KimotoHoitsu/Voiture-guidee-par-main/box.stl

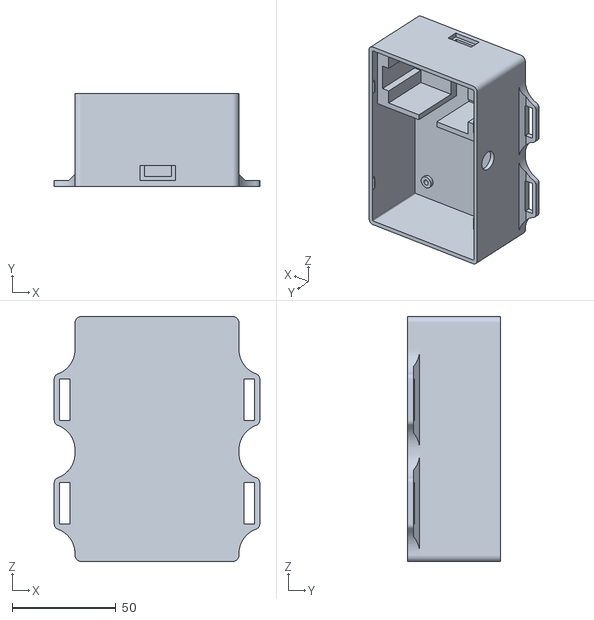
[picture p1: CAD file, 2025-05-15]
box.stl
99.0 x 45.0 x 118.0
