KimotoHoitsu/Voiture-guidee-par-main/Designe 3D (Manette)/Manette/Manette.step

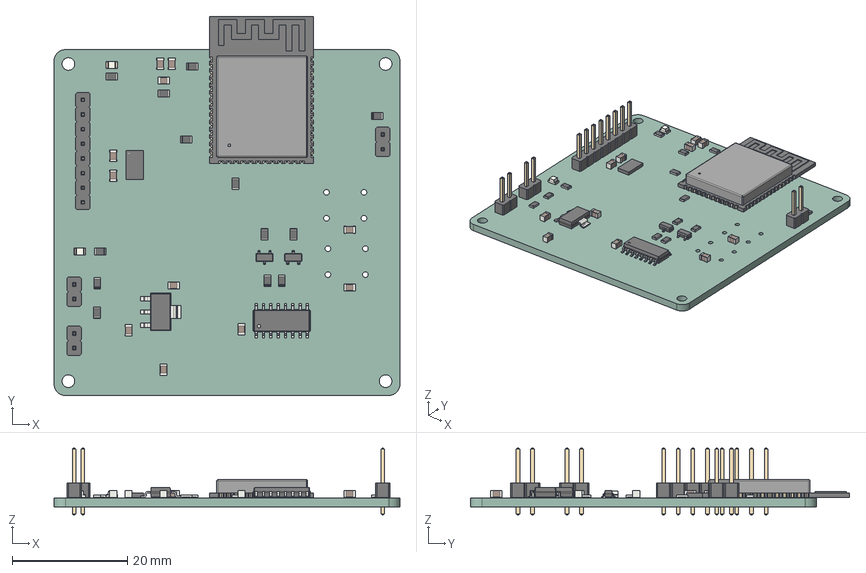
[picture p2: CAD file, 2025-05-15]
Designe 3D (Manette)/Manette/Manette.step
60.0 x 65.8 x 11.5 mm
R_0805_2012Metric x 13
C_0805_2012Metric x 11
LED_0805_2012Metric x 2
ESP32-S3-WROOM-1
PinHeader_1x02_P254mm_Vertical x 3
SOIC_16_39x99mm_P127mm
PinHeader_1x08_P254mm_Vertical
SOT_23 x 2
LGA_14_3x5mm_P08mm_LayoutBorder1x6y
SOT_223
Manette_PCB
