KimotoHoitsu/Voiture-guidee-par-main/Designe 3D (Manette)/Voiture/Voiture.step

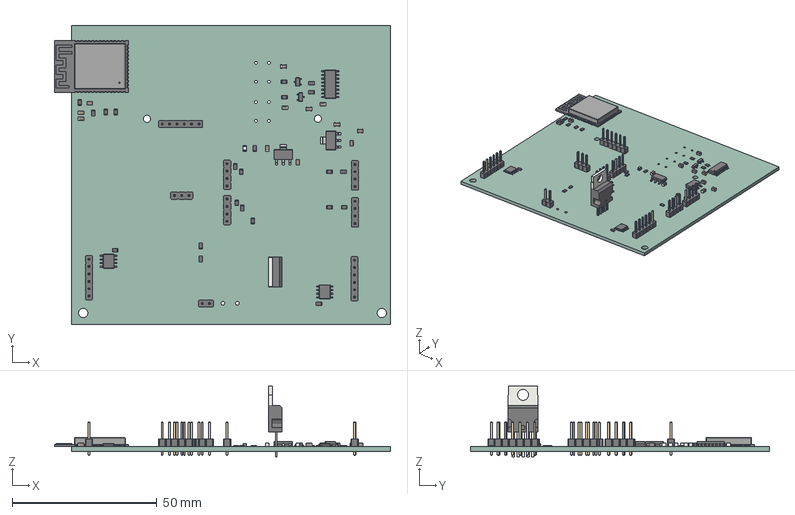
[picture p3: CAD file, 2025-05-15]
Designe 3D (Manette)/Voiture/Voiture.step
115.9 x 103.2 x 24.4 mm
C_0805_2012Metric x 12
PinHeader_1x04_P254mm_Vertical x 4
PinHeader_1x06_P254mm_Vertical x 3
ESP32-S3-WROOM-1
R_0805_2012Metric x 22
LED_0805_2012Metric
TO_220_5_Pentawatt_Multiwatt_5_Vertical
SOT_23 x 2
PinHeader_1x02_P254mm_Vertical
Texas_HTSOP_8_1EP_39x49mm_P127mm_EP285x49mm_Mask24x31mm_ThermalVias x 2
SOT_223 x 2
SOIC_16_39x99mm_P127mm
PinHeader_1x03_P254mm_Vertical
_autosave-Voiture_PCB
