KimotoHoitsu/Voiture-guidee-par-main/lid.stl

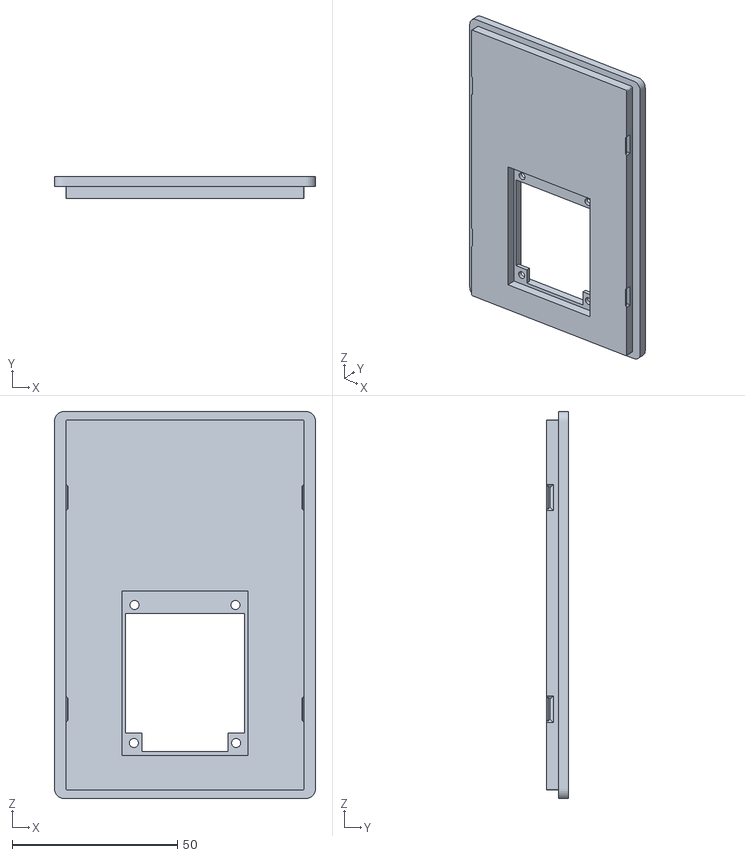
[picture p4: CAD file, 2025-05-15]
lid.stl
79.0 x 6.50 x 117.0
