KimotoHoitsu/Voiture-guidee-par-main/PCB/Manette/Manette.pdf

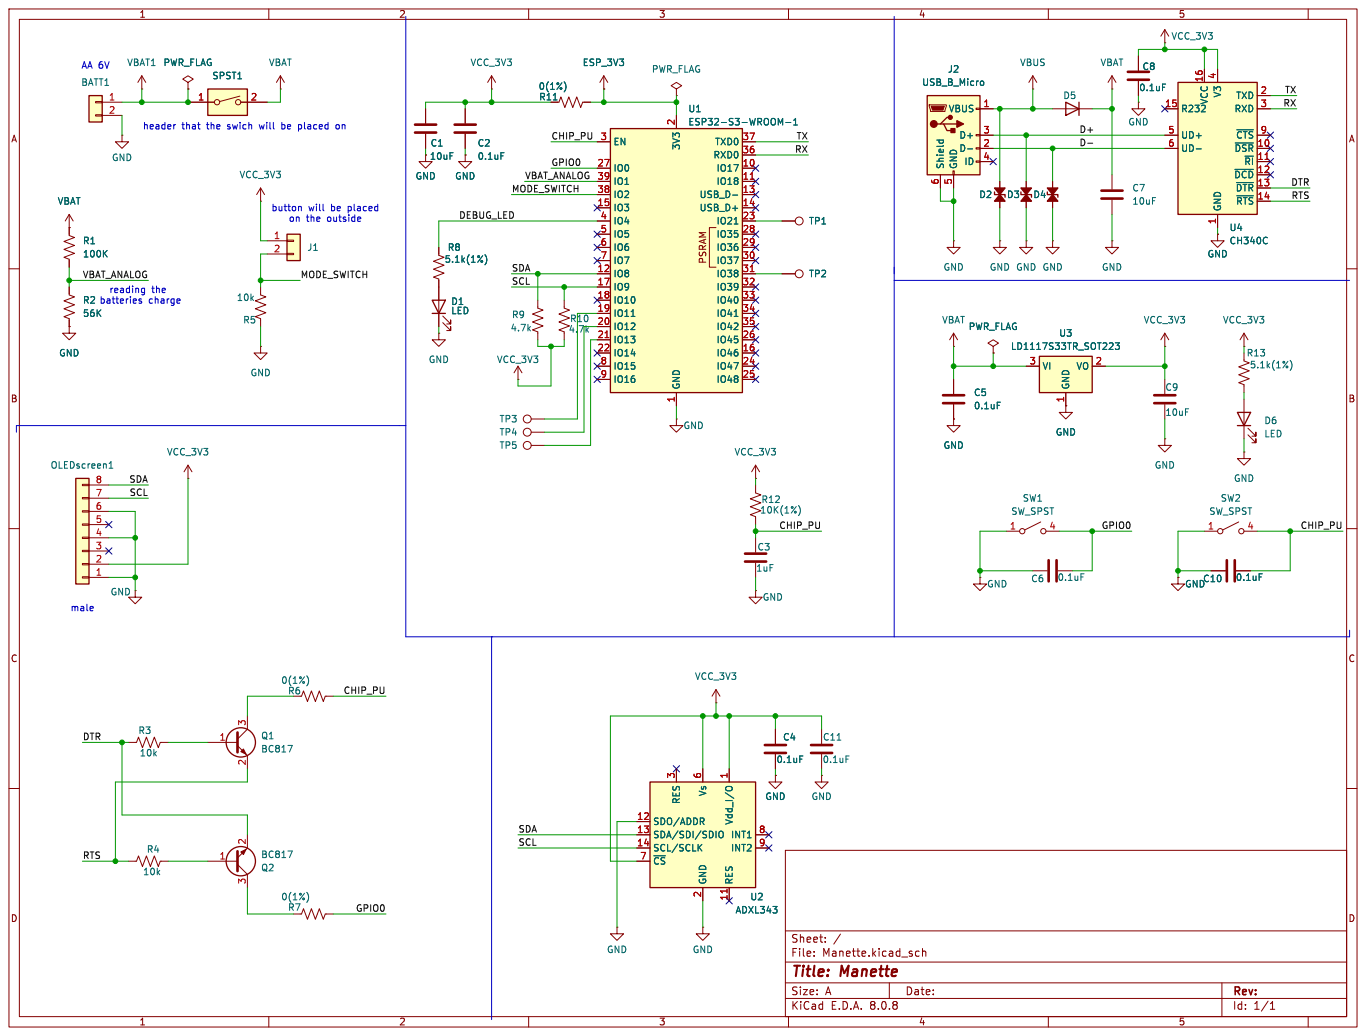
[picture p5: page 1]

1 ~{DSR} 10 ~{RI} 11 ~{DCD} 12 ~{DTR} 13 ~{RTS} 14 R232 15 VCC 16 TXD 2 RXD 3 V3

4 UD+ 5 UD- 6 ~{CTS}9 GND

on the outside male

button will be placed

1 RES 11 SDO/ADDR 12 SDA/SDI/SDIO 13 SCL/SCLK 14 GND
