KimotoHoitsu/Voiture-guidee-par-main/PCB/Voiture/Voiture.pdf

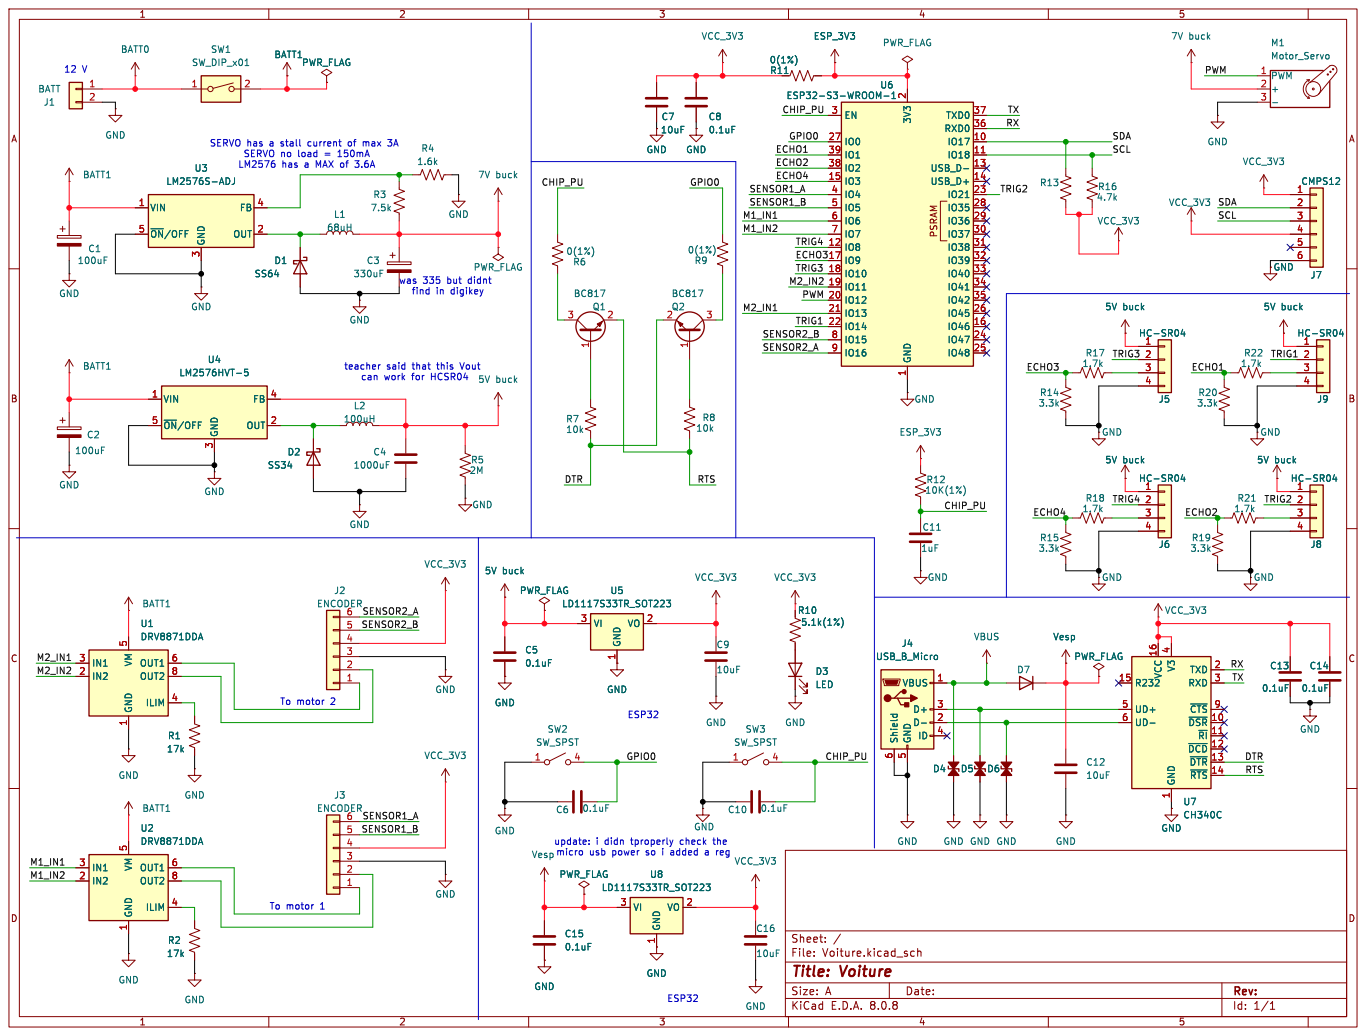
[picture p6: page 1]

3 FB 4 ~{ON}/OFF 5 D1 SS64 U6 ESP32-S3-WROOM-1 GND

SERVO has a stall current of max 3A

teacher said that this Vout can work for HCSR04

4 UD+ 5 UD- 6 ~{CTS}9 Vesp GND
0.1uF PWR_FLAG

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

ESP32 ESP32 To motor 1 To motor 2
