KimotoHoitsu/Voiture-guidee-par-main/PCB/Manette/Manette.kicad_pcb

## KiCad design PCB/Manette/Manette.kicad_pcb (2025-05-15)

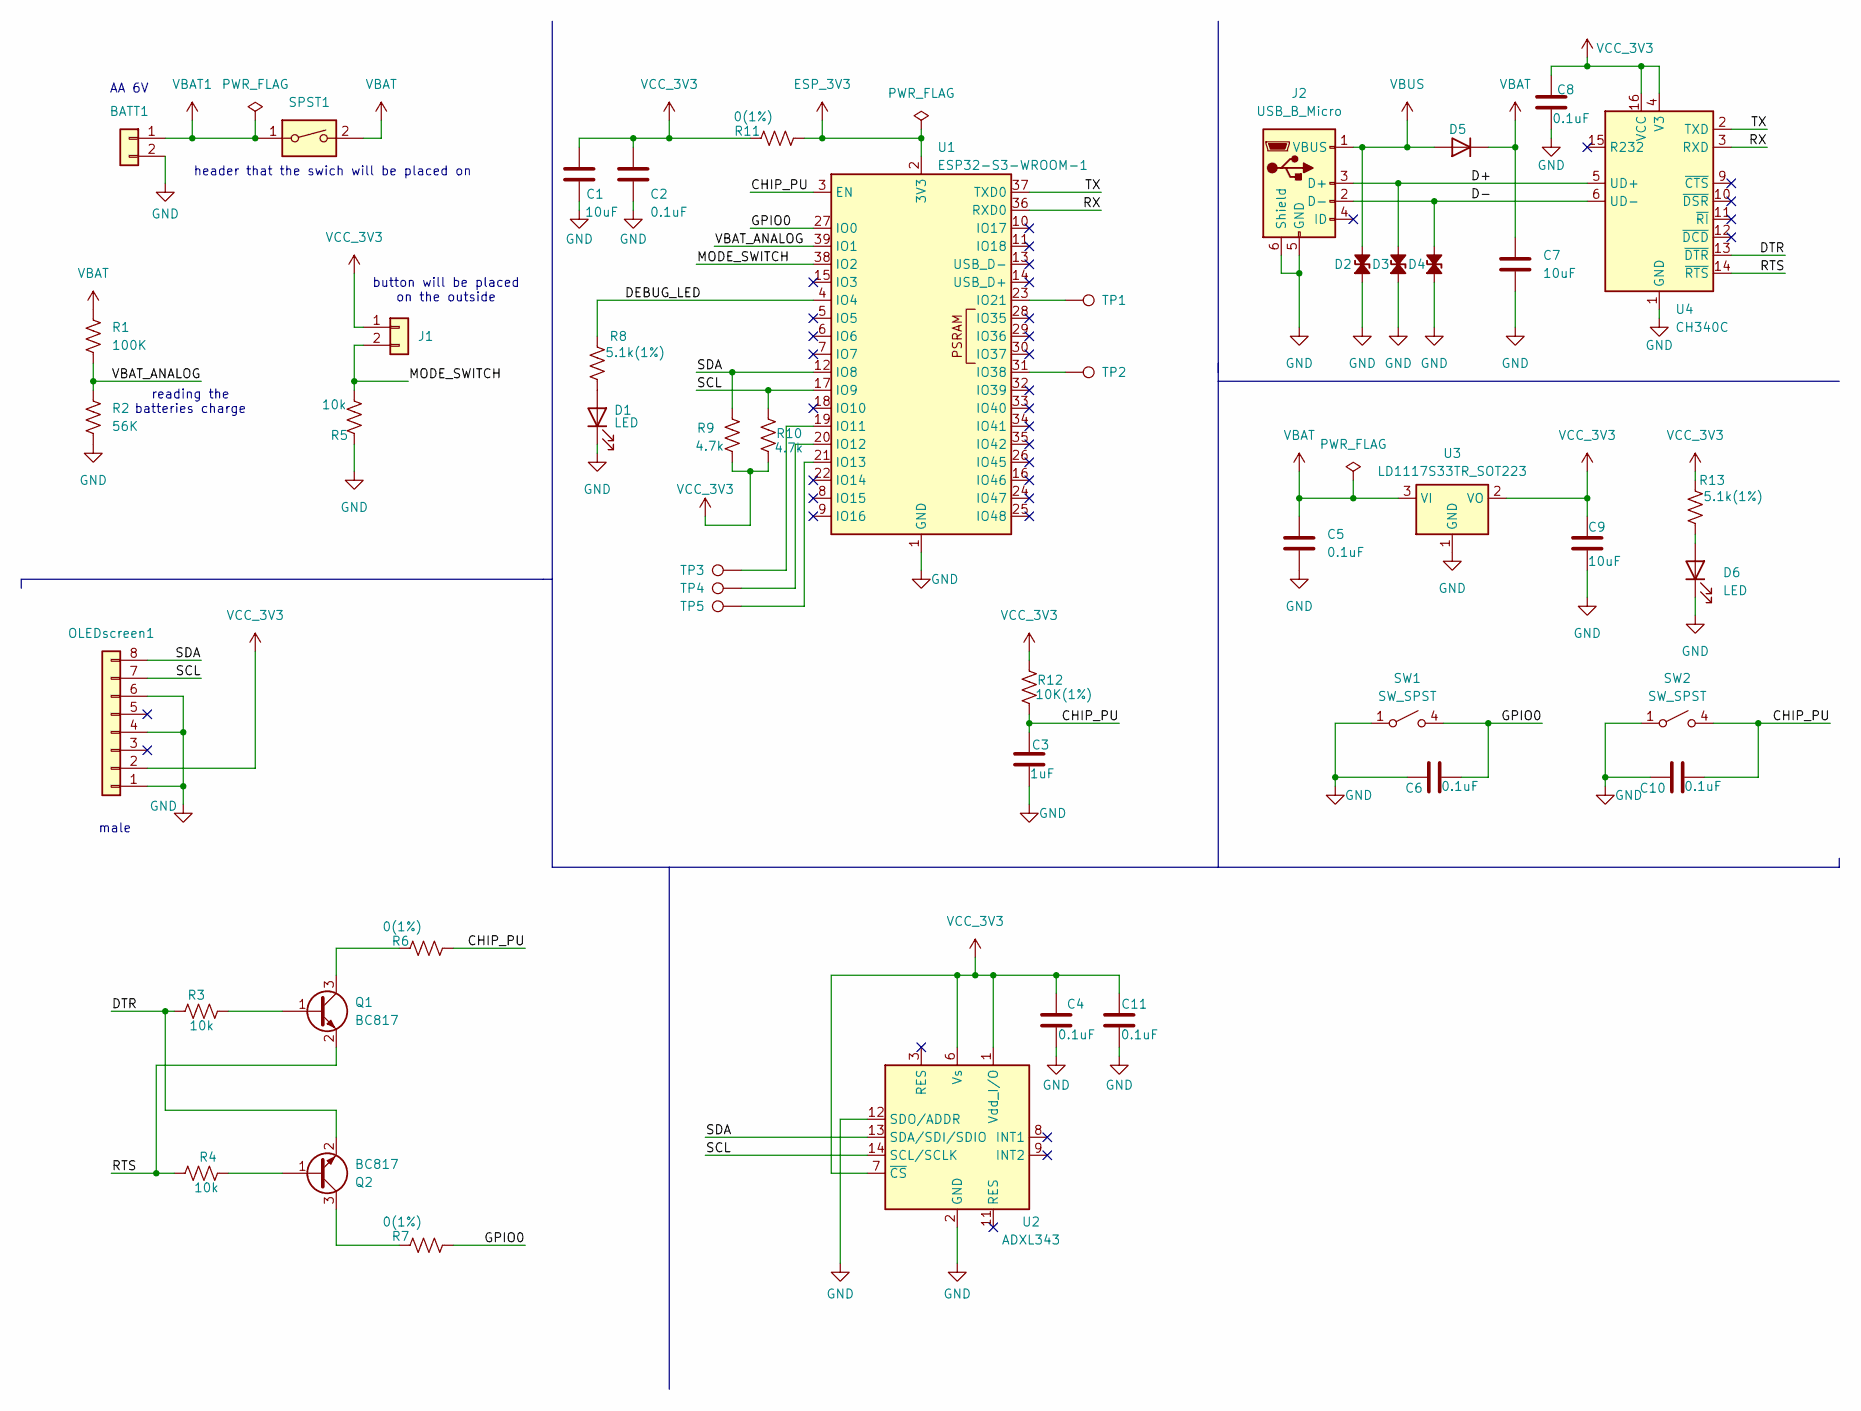
[picture p7: schematic Manette.kicad_sch]

Parts:
BATT1: 9V; PinHeader_1x02_P2.54mm_Vertical
C1, C7, C9: 10uF; C_0805_2012Metric
C2, C4, C5, C6, C8, C10, C11: 0.1uF; C_0805_2012Metric
C3: 1uF; C_0805_2012Metric
D1, D6: LED; LED_0805_2012Metric
D2, D3, D4: DiodeZz
D5: 1N5819HW-7-F_DIO-L
J1: SPST; PinHeader_1x02_P2.54mm_Vertical
J2: USB_B_Micro; Micro_Usb
OLEDscreen1: Conn_01x08; PinHeader_1x08_P2.54mm_Vertical
Q1, Q2: BC817; SOT-23
R1: 100K; R_0805_2012Metric
R2: 56K; R_0805_2012Metric
R3, R4, R5: 10k; R_0805_2012Metric
R6, R7, R11: 0(1%); R_0805_2012Metric
R8, R13: 5.1k(1%); R_0805_2012Metric
R9, R10: 4.7k; R_0805_2012Metric
R12: 10K(1%); R_0805_2012Metric
SPST1: SW_DIP_x01; PinHeader_1x02_P2.54mm_Vertical
SW1: SW_SPST; switch
SW2: SW_SPST; switch; MPN 1825910-6
TP1, TP2: TestPoint; testpoint
TP3, TP4, TP5: TestPoint; TestPoint_Pad_D1.0mm
U1: ESP32-S3-WROOM-1
U2: ADXL343; LGA-14_3x5mm_P0.8mm_LayoutBorder1x6y
U3: LD1117S33TR_SOT223; SOT-223-3_TabPin2
U4: CH340C; SOIC-16_3.9x9.9mm_P1.27mm

Connections:
/CHIP_PU: C3.1, C10.2, R6.2, R12.2, SW2.4 (B), U1.3 (EN)
/D+: D3.2 (A2), J2.3 (D+), U4.5 (UD+)
/D-: D4.2 (A2), J2.2 (D-), U4.6 (UD-)
/DEBUG_LED: R8.2, U1.4 (IO4)
/DTR: Q2.2 (E), R3.2, U4.13 (~DTR)
/GPIO0: C6.2, R7.2, SW1.4 (B), U1.27 (IO0)
/MODE_SWITCH: J1.2, R5.2, U1.38 (IO2)
/RTS: Q1.2 (E), R4.1, U4.14 (~RTS)
/RX: U1.36 (RXD0), U4.3 (RXD)
/SCL: OLEDscreen1.7 (CLK), R10.1, U1.17 (IO9), U2.14 (SCL/SCLK)
/SDA: OLEDscreen1.8 (DATA), R9.1, U1.12 (IO8), U2.13 (SDA/SDI/SDIO)
/TX: U1.37 (TXD0), U4.2 (TXD)
/VBAT_ANALOG: R1.1, R2.2, U1.39 (IO1)
ESP_3V3: R11.2, U1.2 (3V3)
GND: BATT1.2, C1.2, C2.2, C3.2, C4.1, C5.2, C6.1, C7.2, C8.2, C9.2, C10.1, C11.1, D1.1 (K), D2.1 (A1), D3.1 (A1), D4.1 (A1), D6.1 (K), J2.5 (GND), J2.6 (Shield), OLEDscreen1.1 (GND), OLEDscreen1.4 (CS), OLEDscreen1.6 (DC), R2.1, R5.1, SW1.1 (A), SW2.1 (A), U1.1 (GND), U1.40 (GND), U1.41 (GND), U2.2 (GND), U2.4 (GND), U2.5 (GND), U2.12 (SDO/ADDR), U3.1 (GND), U4.1 (GND)
unnamed: D1.2 (A), R8.1
unnamed: D6.2 (A), R13.1
unnamed: Q1.1 (B), R3.1
unnamed: Q1.3 (C), R6.1
unnamed: Q2.1 (B), R4.2
unnamed: Q2.3 (C), R7.1
unnamed: TP3.1, U1.19 (IO11)
unnamed: TP4.1, U1.20 (IO12)
unnamed: TP5.1, U1.21 (IO13)
unnamed: TP1.1, U1.23 (IO21)
unnamed: TP2.1, U1.31 (IO38)
VBAT: C5.1, C7.1, D5.1 (K), R1.2, SPST1.2, U3.3 (VI)
VBAT1: BATT1.1, SPST1.1
VBUS: D2.2 (A2), D5.2 (A), J2.1 (VBUS)
VCC_3V3: C1.1, C2.1, C4.2, C8.1, C9.1, C11.2, J1.1, OLEDscreen1.2 (Vin), R9.2, R10.2, R11.1, R12.1, R13.2, U2.1 (Vdd_I/O), U2.6 (Vs), U2.7 (~CS), U3.2 (VO), U4.4 (V3), U4.16 (VCC)

Notes on the sheet:
reading the batteries charge
male
AA 6V
button will be placed on the outside
header that the swich will be placed on

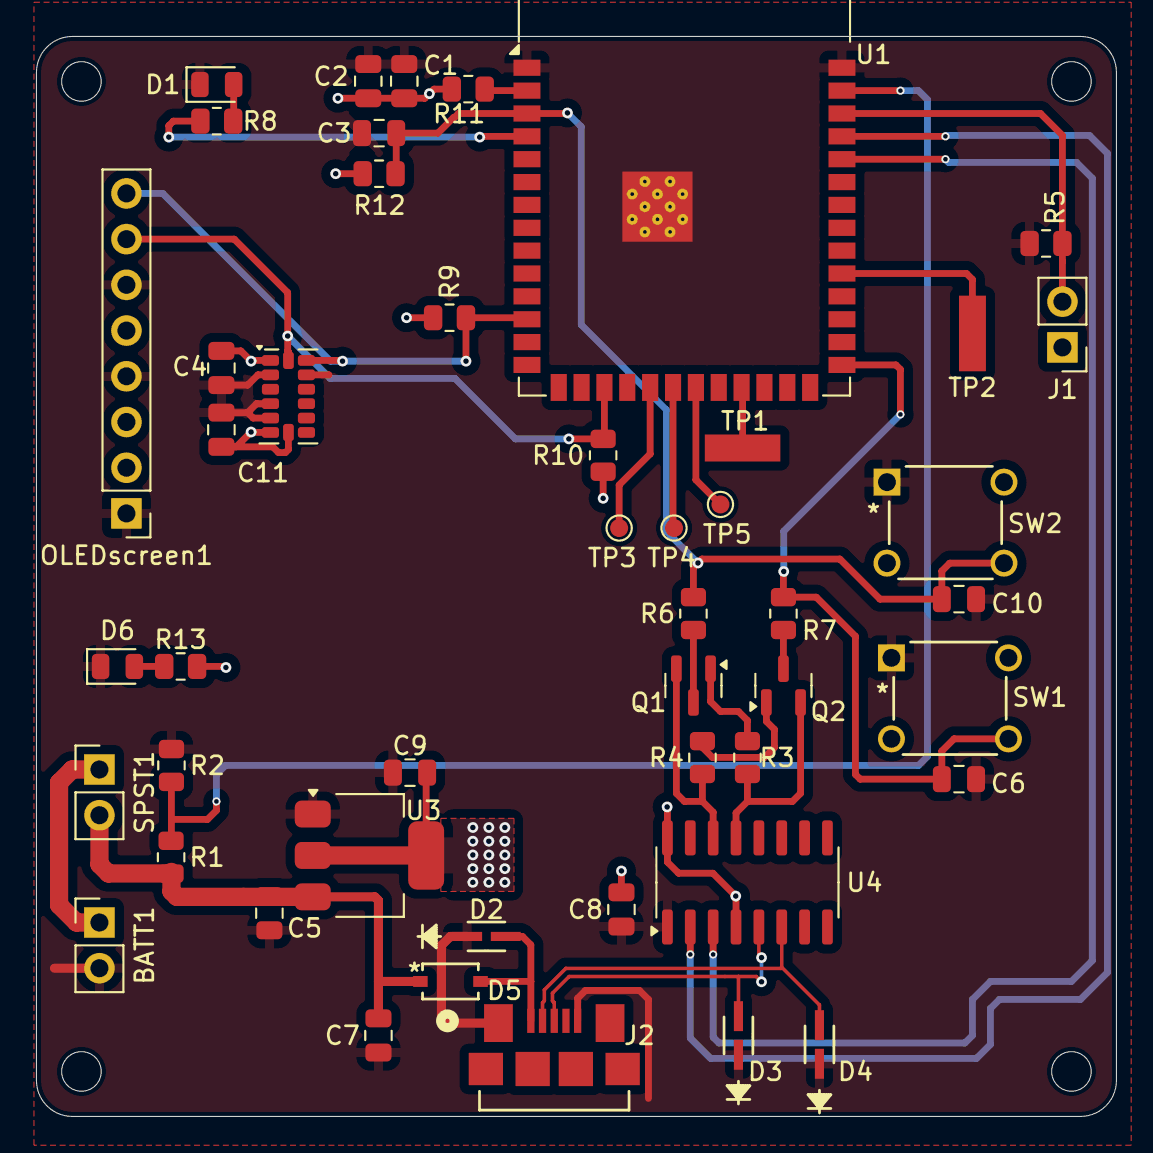
[picture p8: board Manette.kicad_pcb from above]

Board: 2 copper layers, 60.0 x 60.0 mm, 52 parts (0 on the bottom side), 30 nets.

Other parts of the board:
H1, H2, H3, H4: MountingHole_2.2mm_M2
