KimotoHoitsu/Voiture-guidee-par-main/PCB/Voiture/Voiture.kicad_pcb

## KiCad design PCB/Voiture/Voiture.kicad_pcb (2025-05-15)

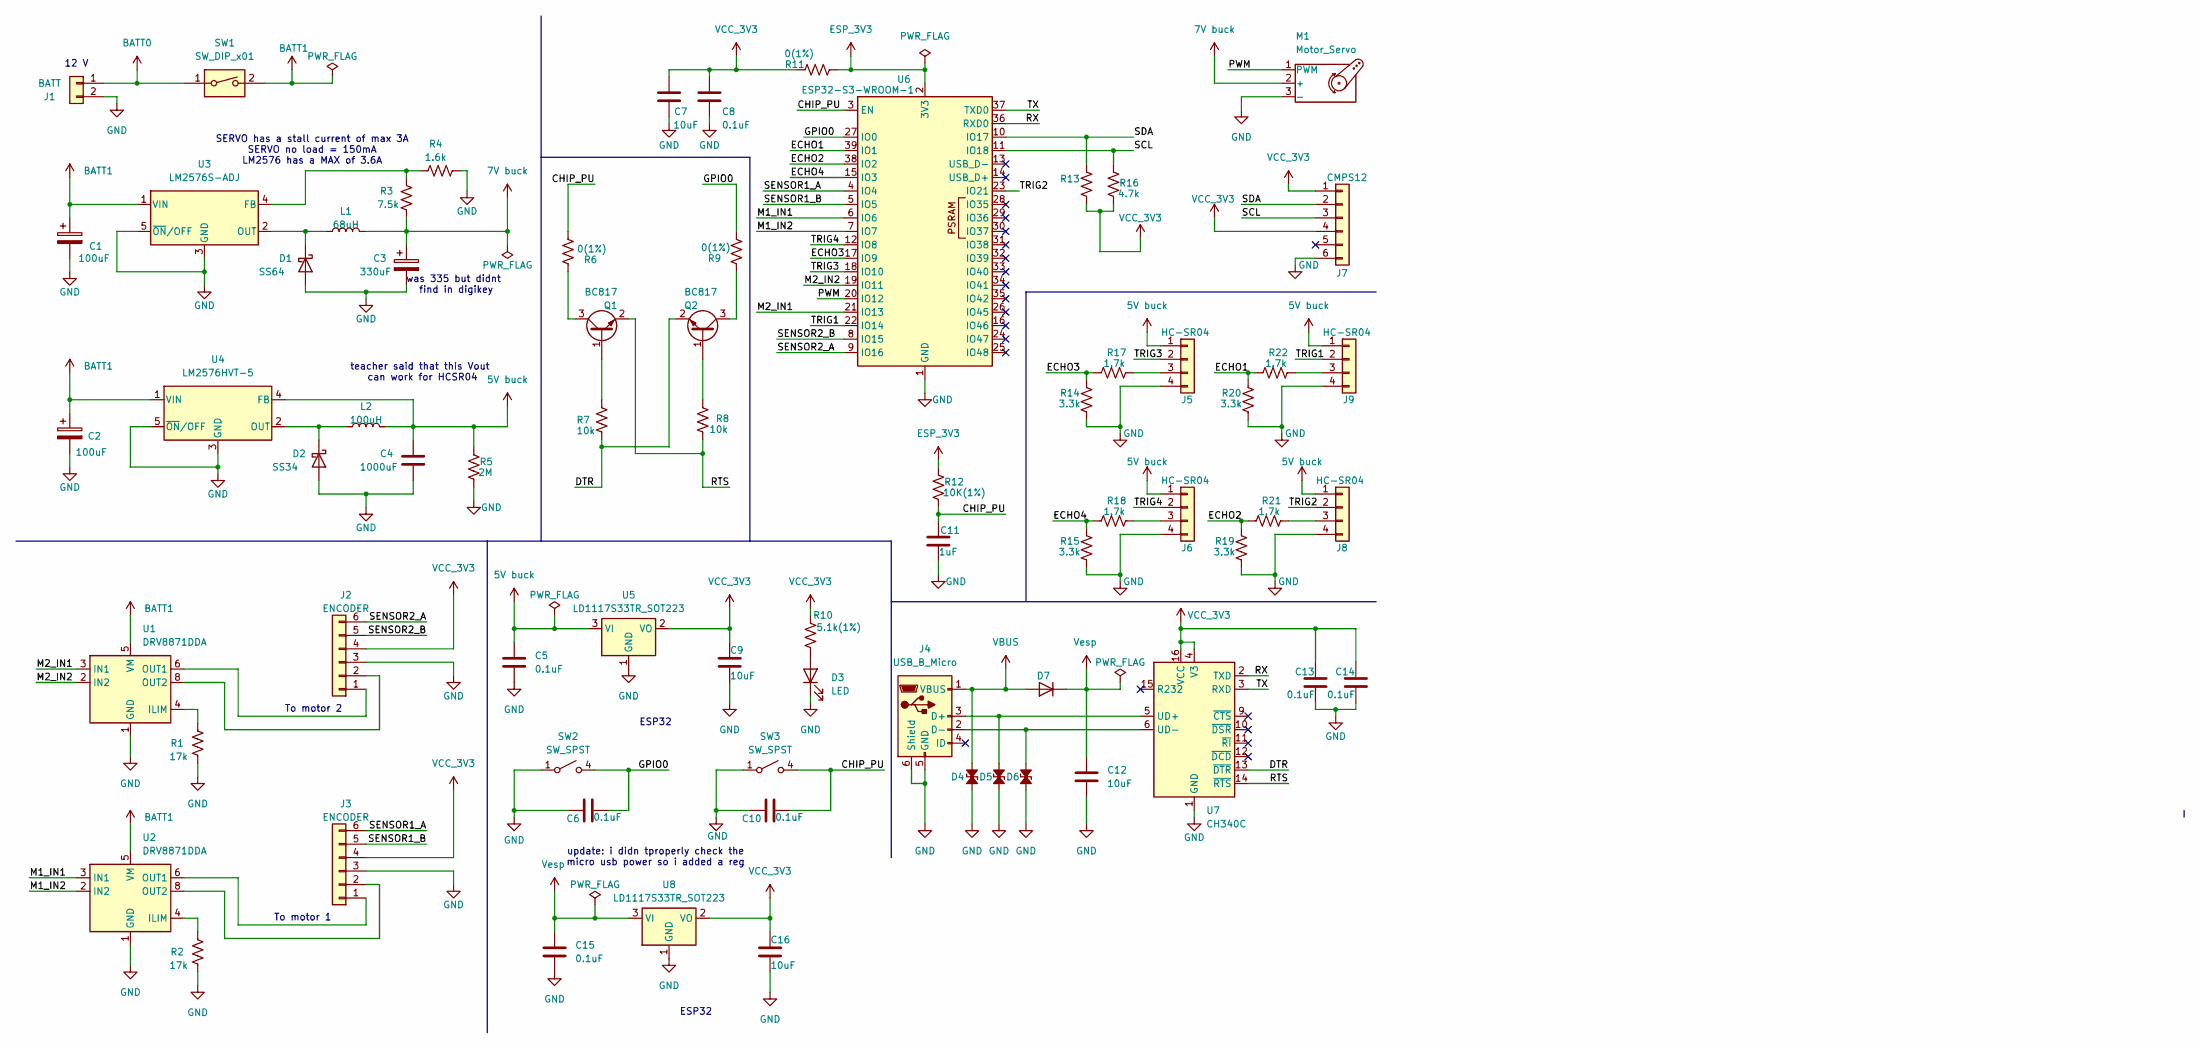
[picture p9: schematic Voiture.kicad_sch]

Parts:
C1, C2: 100uF; CAP_E61_CHC-M
C3: 330uF; CAP_APXG160ARA331MH70G
C4: 1000uF; CAP_A768MS_KEM-M
C5, C6, C8, C10, C13, C14, C15: 0.1uF; C_0805_2012Metric
C7, C9, C12, C16: 10uF; C_0805_2012Metric
C11: 1uF; C_0805_2012Metric
D1: SS64; ss34
D2: SS34; ss34
D3: LED; LED_0805_2012Metric
D4, D5, D6: DiodeZz
D7: 1N5819HW-7-F_DIO-L
J1: BATT; CONN_1935310_PXC
J2, J3: ENCODER; PinHeader_1x06_P2.54mm_Vertical
J4: USB_B_Micro; Micro_Usb
J5, J6, J8, J9: HC-SR04; PinHeader_1x04_P2.54mm_Vertical
J7: CMPS12; PinHeader_1x06_P2.54mm_Vertical
L1: 68uH; IND_DR127_EAT
L2: 100uH; DR127
M1: Motor_Servo; PinHeader_1x03_P2.54mm_Vertical
Q1, Q2: BC817; SOT-23
R1, R2: 17k; R_0805_2012Metric
R3: 7.5k; R_0805_2012Metric
R4: 1.6k; R_0805_2012Metric
R5: 2M; R_0805_2012Metric
R6, R9, R11: 0(1%); R_0805_2012Metric
R7, R8: 10k; R_0805_2012Metric
R10: 5.1k(1%); R_0805_2012Metric
R12: 10K(1%); R_0805_2012Metric
R13, R16: 4.7k; R_0805_2012Metric
R14, R15, R19, R20: 3.3k; R_0805_2012Metric
R17, R18, R21, R22: 1.7k; R_0805_2012Metric
SW1: SW_DIP_x01; PinHeader_1x02_P2.54mm_Vertical
SW2, SW3: SW_SPST; switch
U1, U2: DRV8871DDA; Texas_HTSOP-8-1EP_3.9x4.9mm_P1.27mm_EP2.95x4.9mm_Mask2.4x3.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
U3: LM2576S-ADJ; VREG_TPS79625KTTR
U4: LM2576HVT-5; TO-220-5_Vertical
U5, U8: LD1117S33TR_SOT223; SOT-223-3_TabPin2
U6: ESP32-S3-WROOM-1
U7: CH340C; SOIC-16_3.9x9.9mm_P1.27mm

Connections:
5V buck: C4.1, C5.1, J5.1 (VCC), J6.1 (VCC), J8.1 (VCC), J9.1 (VCC), L2.2, R5.1, U4.4 (FB), U5.3 (VI)
7V buck: C3.1, C3.P, L1.2, M1.2 (+), R3.2
/CHIP_PU: C10.2, C11.1, R6.2, R12.2, SW3.4 (B), U6.3 (EN)
/DTR: Q2.2 (E), R7.2, U7.13 (~DTR)
/ECHO1: R20.1, R22.1, U6.39 (IO1)
/ECHO2: R19.1, R21.1, U6.38 (IO2)
/ECHO3: R14.1, R17.1, U6.17 (IO9)
/ECHO4: R15.1, R18.1, U6.15 (IO3)
/GPIO0: C6.2, R9.2, SW2.4 (B), U6.27 (IO0)
/M1_IN1: U2.3 (IN1), U6.6 (IO6)
/M1_IN2: U2.2 (IN2), U6.7 (IO7)
/M2_IN1: U1.3 (IN1), U6.21 (IO13)
/M2_IN2: U1.2 (IN2), U6.19 (IO11)
/PWM: M1.1 (PWM), U6.20 (IO12)
/RTS: Q1.2 (E), R8.1, U7.14 (~RTS)
/RX: U6.36 (RXD0), U7.2 (TXD)
/SCL: J7.3 (SCL), R16.1, U6.11 (IO18)
/SDA: J7.2 (SDA), R13.1, U6.10 (IO17)
/SENSOR1_A: J3.6 (SENSORsigA), U6.4 (IO4)
/SENSOR1_B: J3.5 (SENSORsigB), U6.5 (IO5)
/SENSOR2_A: J2.6 (SENSORsigA), U6.9 (IO16)
/SENSOR2_B: J2.5 (SENSORsigB), U6.8 (IO15)
/TRIG1: J9.2 (Trig), U6.22 (IO14)
/TRIG2: J8.2 (Trig), U6.23 (IO21)
/TRIG3: J5.2 (Trig), U6.18 (IO10)
/TRIG4: J6.2 (Trig), U6.12 (IO8)
/TX: U6.37 (TXD0), U7.3 (RXD)
BATT0: J1.1, SW1.1
BATT1: C1.1, C2.1, SW1.2, U1.5 (VM), U2.5 (VM), U3.1 (VIN), U4.1 (VIN)
ESP_3V3: R11.2, R12.1, U6.2 (3V3)
GND: C1.2, C2.2, C3.2, C3.N, C4.2, C5.2, C6.1, C7.2, C8.2, C9.2, C10.1, C11.2, C12.2, C13.2, C14.2, C15.2, C16.2, D1.2 (A), D2.2 (A), D3.1 (K), D4.1 (A1), D5.1 (A1), D6.1 (A1), J1.2, J2.3 (SENSOR_GND), J3.3 (SENSOR_GND), J4.5 (GND), J4.6 (Shield), J5.4 (GND), J6.4 (GND), J7.6 (GND), J8.4 (GND), J9.4 (GND), M1.3 (-), R1.1, R2.1, R4.2, R5.2, R14.2, R15.2, R19.2, R20.2, SW2.1 (A), SW3.1 (A), U1.1 (GND), U1.7 (GND), U1.9 (GND), U2.1 (GND), U2.7 (GND), U2.9 (GND), U3.3 (GND), U3.5 (~ON/OFF), U4.3 (GND), U4.5 (~ON/OFF), U5.1 (GND), U6.1 (GND), U6.40 (GND), U6.41 (GND), U7.1 (GND), U8.1 (GND)
unnamed: D1.1 (K), L1.1, U3.2 (OUT)
unnamed: D2.1 (K), L2.1, U4.2 (OUT)
unnamed: D3.2 (A), R10.1
unnamed: D5.2 (A2), J4.3 (D+), U7.5 (UD+)
unnamed: D6.2 (A2), J4.2 (D-), U7.6 (UD-)
unnamed: J2.2 (MOTOR-), U1.8 (OUT2)
unnamed: J2.1 (MOTOR_+), U1.6 (OUT1)
unnamed: J3.2 (MOTOR-), U2.8 (OUT2)
unnamed: J3.1 (MOTOR_+), U2.6 (OUT1)
unnamed: J5.3 (Echo), R17.2
unnamed: J6.3 (Echo), R18.2
unnamed: J8.3 (Echo), R21.2
unnamed: J9.3 (Echo), R22.2
unnamed: Q1.1 (B), R7.1
unnamed: Q1.3 (C), R6.1
unnamed: Q2.1 (B), R8.2
unnamed: Q2.3 (C), R9.1
unnamed: R1.2, U1.4 (ILIM)
unnamed: R2.2, U2.4 (ILIM)
unnamed: R3.1, R4.1, U3.4 (FB)
VBUS: D4.2 (A2), D7.2 (A), J4.1 (VBUS)
VCC_3V3: C7.1, C8.1, C9.1, C13.1, C14.1, C16.1, J2.4 (VCC(5V5)), J3.4 (VCC(5V5)), J7.1 (Vin), J7.4 (Mode), R10.2, R11.1, R13.2, R16.2, U5.2 (VO), U7.4 (V3), U7.16 (VCC), U8.2 (VO)
Vesp: C12.1, C15.1, D7.1 (K), U8.3 (VI)

Notes on the sheet:
ESP32
To motor 2
To motor 1
teacher said that this Vout can work for HCSR04
was 335 but didnt find in digikey
update: i didn tproperly check the micro usb power so i added a reg
12 V
SERVO has a stall current of max 3A SERVO no load = 150mA LM2576 has a MAX of 3.6A

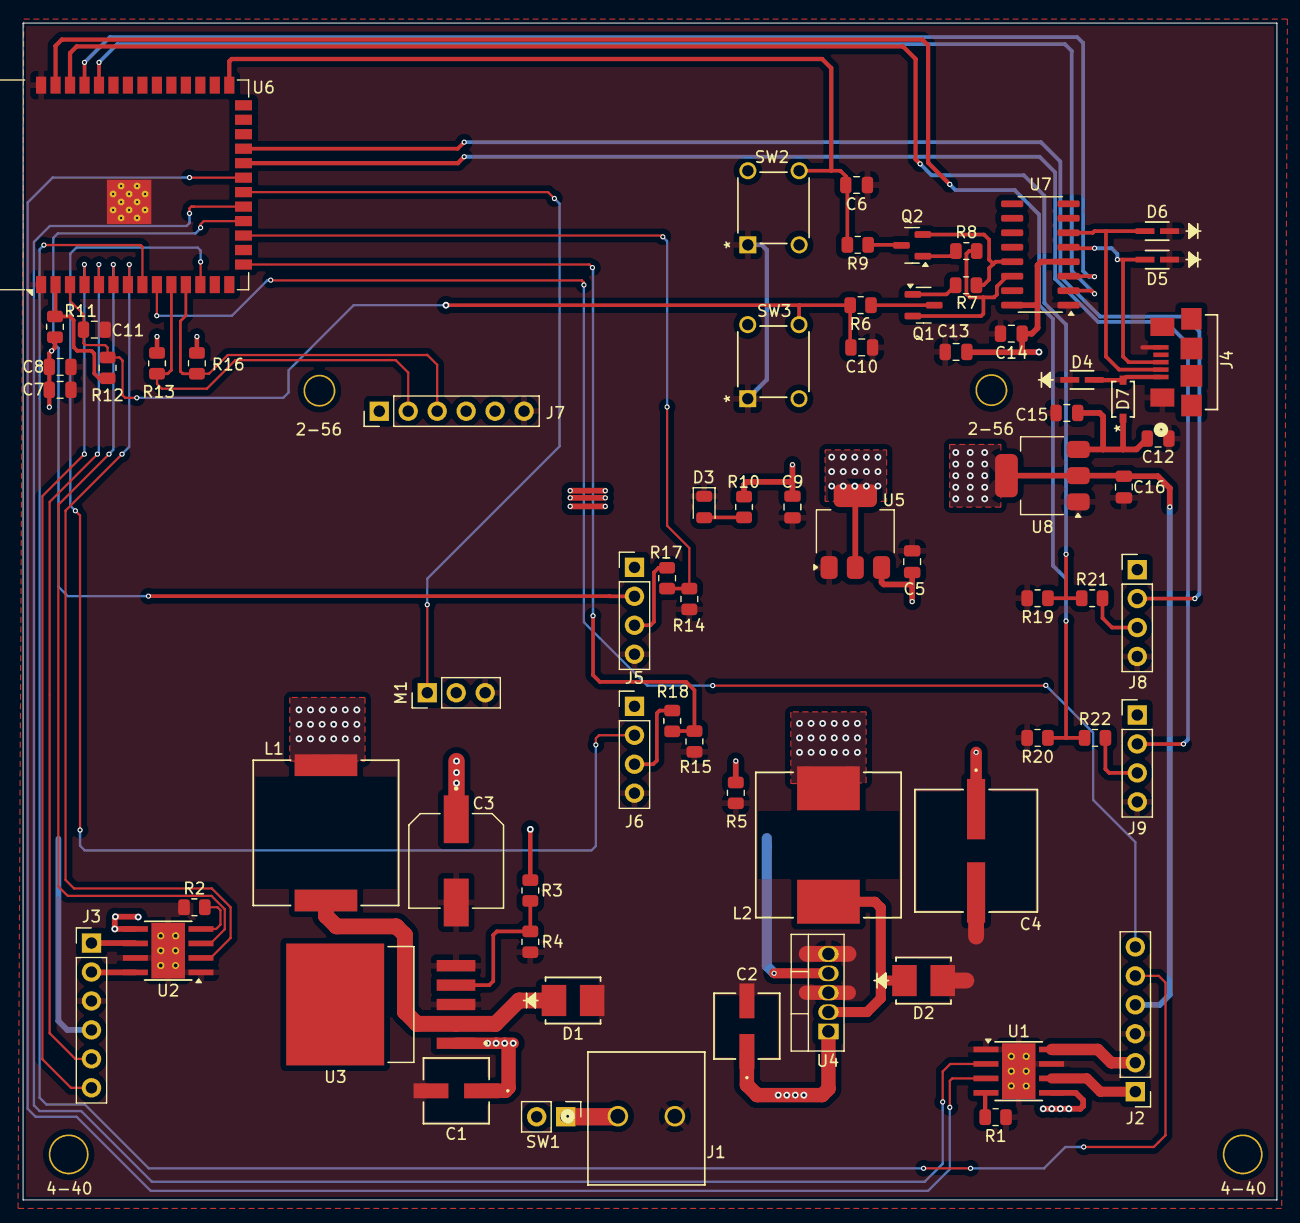
[picture p10: board Voiture.kicad_pcb from above]

Board: 2 copper layers, 110.0 x 103.2 mm, 74 parts (0 on the bottom side), 54 nets.

Other parts of the board:
2-56, 2-56#2: MountingHole_2.5mm
4-40, 4-40#2: MountingHole_3.2mm_M3
